coredump/linux-fingerprint-r503/(commit log)

2026-05-28 feat(d1mini): port firmware to ESP8266/D1 Mini + Arch PKGBUILD + Stop fix
    Firmware:
    - Port r503fp and all 11 diagnostic sketches from Arduino Nano (ATmega328P)
    to WeMos D1 Mini (ESP8266MOD)
    - EspSoftwareSerial on GPIO14/12 (D5/D6) for R503 UART at 57600
    - EEPROM.begin(192) + EEPROM.commit() replacing EEPROM.update() throughout
    - LED_ON/LED_OFF macros for active-LOW LED_BUILTIN (GPIO2)
    - yield() in polling loops for ESP8266 soft-WDT hygiene
    - CI swapped to esp8266:esp8266:d1_mini FQBN; arduino:avr removed
    Packaging:
    - Add packaging/arch/PKGBUILD for pacman-tracked install/removal
    - provides=('fprintd') with no conflicts=; fprintd tools coexist while
    daemon is masked via systemctl in the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
    [eeprom.h, r503fp.ino, r503fp_baudsweep.ino, r503fp_clean.ino, r503fp_listen.ino, r503fp_loopback.ino]
2026-05-29 feat: emit PropertiesChanged for finger-needed/present + D1 Mini addendum
    - dbus_iface: fix finger_needed_changed/finger_present_changed calls —
    they are instance methods; use self.finger_needed_changed() in method
    handlers and ObjectServer lookup in the spawned-task free function.
    fprintd-enroll/verify now print "Place your finger on the sensor."
    - README: add D1 Mini vs Nano comparison table, 3D-printed case photo
    (docs/images/case-d1mini.jpg), and Printables link; drop stale
    "wish I had a 3d printer" note; update Limitations to reflect that
    PropertiesChanged is now emitted.
